jwon711/Ultimate-Tensile-Strength-Tester---Team-7/README.md

# Ultimate Tensile Strength Tester
 Improving a Ultimate Tensile Strength Tester for the Chemistry Department

## Repository Contents
 ##### Item 1: Reports 
 - Contains written reports that expresses our ideas, replicates our system and displays system data analysis
 ##### Item 2: Source Code
 - Contains well organized and commentated code that implements the system's logic
 ##### Item 3: Presentations
 - Contains a poster and powerpoint that concludes our final product
 ##### Item 4: Misc
 - Includes a user's guide that will help the user know how to interact with the machine
 
## System Parts
 ##### Part 1: Temperature / Humidity Sensor
 - Cost: $10.29
 - Link: https://www.amazon.com/HiLetgo-Temperature-Humidity-Digital-3-3V-5V/dp/B01DKC2GQ0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
 ##### Part 2: LCD screen with I2C
 - Cost: $10.99
 - Link: https://www.amazon.com/GeeekPi-Character-Backlight-Raspberry-Electrical/dp/B07S7PJYM6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
 ##### Part 3: Kevlar Rope
 - Cost: $9.99
 - Link: https://www.amazon.com/9KM-DWLIFE-50lb-1800lbs-Ultralight-Activities/dp/B07X9F17YW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
 ##### Part 4: Pulley
 - Cost: $14.99
 - Link: https://www.amazon.com/Single-Pulley-Creatiee-Stainless-Loading/dp/B07CVSNC2Y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
 ##### Part 5: Push / Pull Force Clamps (2)
 - Cost: $56.18
 - Link: https://www.amazon.com/SJJ-01-2-Push-Pull-Fixture-Stainless-Capacity/dp/B0874WFQGM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
 ##### Part 6: M6 x 16mm Double End Threaded Stud Screw (2)
 - Cost: $5.18 at Ace Hardware
 - Link: https://www.amazon.com/10-M6-1-0-16mm-Stainless-MonsterBolts/dp/B079585D8X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
 ##### Part 7: M6 Threaded Insert (2)
 - Cost: $2.58 at Ace Hardware
 - Link: https://www.amazon.com/Z-400-M6-Threaded-Internal-Threads/dp/B002WC8TRA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
 ##### Part 8: Everbilt #8 x 1-½ in pan head phillips (2)
 - Cost: $1.28
 - Link: https://www.homedepot.com/p/Everbilt-8-x-1-1-2-in-Phillips-Pan-Head-Stainless-Steel-Sheet-Metal-Screw-2-Pack-801081/204275411
 ##### Part 9: Everbilt 9/16 in rope loop (1)
 - Cost: $3.41
 - Link: https://www.homedepot.com/p/Everbilt-9-16-in-Stainless-Steel-Rope-Loop-42634/205887675

## Software Dependencies
  ##### Dependency 1: Libaries
  - DHTLib [DHTLib.zip](https://github.com/jwon711/Ultimate-Tensile-Strength-Tester---Team-7/files/8577816/DHTLib.zip
  - DHTStable [DHTStable.zip](https://github.com/jwon711/Ultimate-Tensile-Strength-Tester---Team-7/files/8577819/DHTStable.zip)
  - HX711_Arduino_Library [HX711_Arduino_Library.zip](https://github.com/jwon711/Ultimate-Tensile-Strength-Tester---Team-7/files/8577825/HX711_Arduino_Library.zip)
  - Arduino-LiquidCrystal-I2C-library-master [Arduino-LiquidCrystal-I2C-library-master.zip](https://github.com/jwon711/Ultimate-Tensile-Strength-Tester---Team-7/files/8577827/Arduino-LiquidCrystal-I2C-library-master.zip)
  ##### Dependency 2: CoolTermWin (Software to interact with Serial Monitor Data without using Arduino and to export data to excel)
   - Download Link: https://freeware.the-meiers.org/#CoolTerm
   - Youtube Video Guide: https://www.youtube.com/watch?v=RWgyCcnUxPY
